duankoi888/adjustable-buck-converter/images/photo-1.jpg

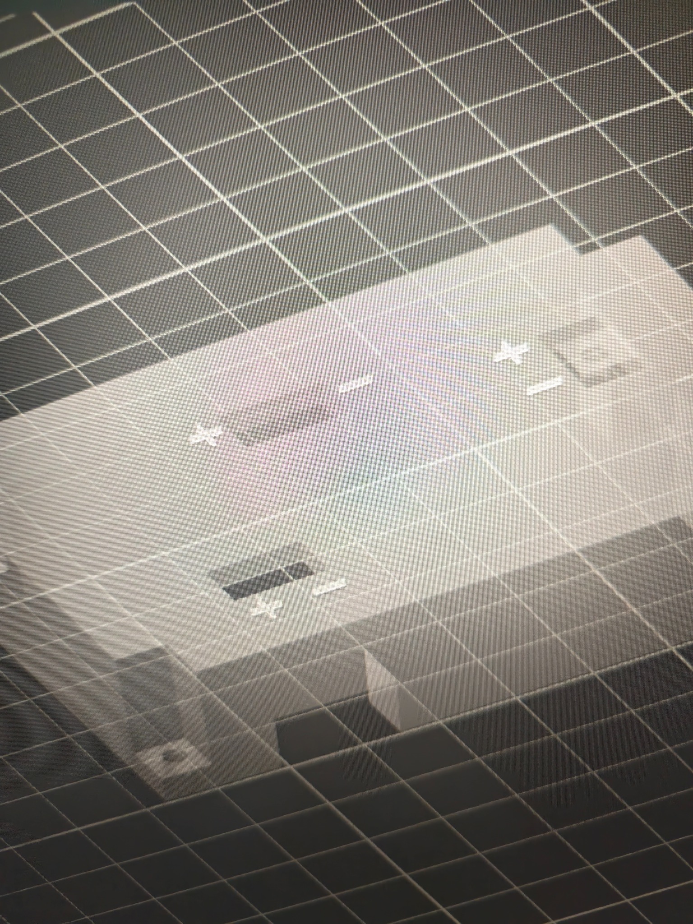
images/photo-1.jpg
