duankoi888/adjustable-buck-converter/images/photo-3.jpg

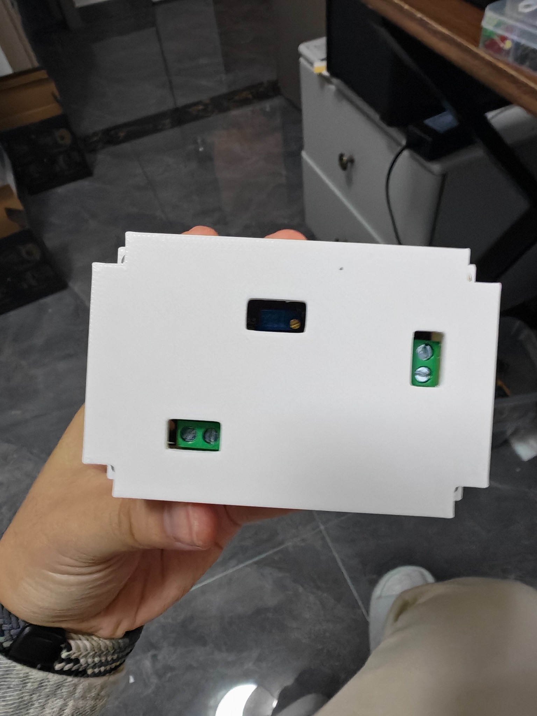
images/photo-3.jpg
