duankoi888/adjustable-buck-converter/docs/bom.xlsx

No. | Quantity | Comment | Designator | Footprint | Value | Manufacturer Part | Manufacturer | Supplier Part | Supplier
1 | 1 | 220uF | C1 | CAP-SMD_BD6.3-L6.6-W6.6-FD-A | 220uF | EFVM035ADA221M0677 | FOLLON(富隆电子) | C22388078 | LCSC
2 | 1 | 470uF | C2 | CAP-SMD_BD10.0-L10.4-W10.4-LS11.2-FD_H12.5 | 470uF | EFVM050ADA471M10C0 | FOLLON(富隆电子) | C22469994 | LCSC
3 | 1 | SS54 | D1 | SMA_L4.4-W2.8-LS5.4-R-RD |  | SS54 | MDD(辰达半导体) | C22452 | LCSC
4 | 1 | SS34 | D2 | SMA_L4.3-W2.6-LS5.2-RD |  | SS34 | MDD(辰达半导体) | C8678 | LCSC
5 | 1 | 68uH | L1 | IND-SMD_L12.5-W12.5 | 68uH | CYH125-68UH | SHOU HAN(首韩) | C7431083 | LCSC
6 | 2 | WJ500V-5.08-2P | P1,P2 | CONN-TH_2P-P5.00_WJ500V-5.08-2P |  | WJ500V-5.08-2P | KANGNEX(康奈克斯电气) | C8465 | LCSC
7 | 2 | 1kΩ | R1,R3 | R0603 | 1kΩ | FRC0603F1001TS | FOJAN(富捷) | C2907002 | LCSC
8 | 1 | 5kΩ | R2 | RES-ADJ-TH_3296W | 5kΩ | 3296W-1-502LF | BOURNS | C60620 | LCSC
9 | 1 | LM2596HVS-ADJ(UMW) | U1 | TO-263-5_L10.0-W8.4-P1.70-LS15.3-BR |  | LM2596HVS-ADJ(UMW) | UMW(友台半导体) | C347447 | LCSC
