duankoi888/adjustable-buck-converter/hardware/enclosure/source/上下盖装配.SLDASM

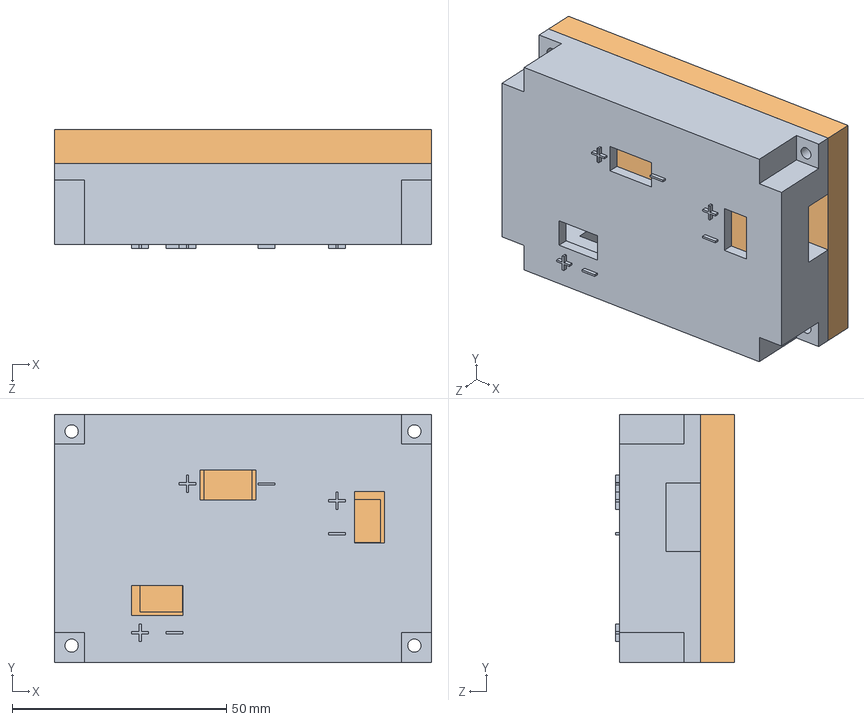
[picture p4: CAD file, 2026-10-30]
hardware/enclosure/source/上下盖装配.SLDASM
88.0 x 58.0 x 27.8 mm
底座_固定
上盖
