duankoi888/adjustable-buck-converter/hardware/enclosure/source/上盖.SLDPRT

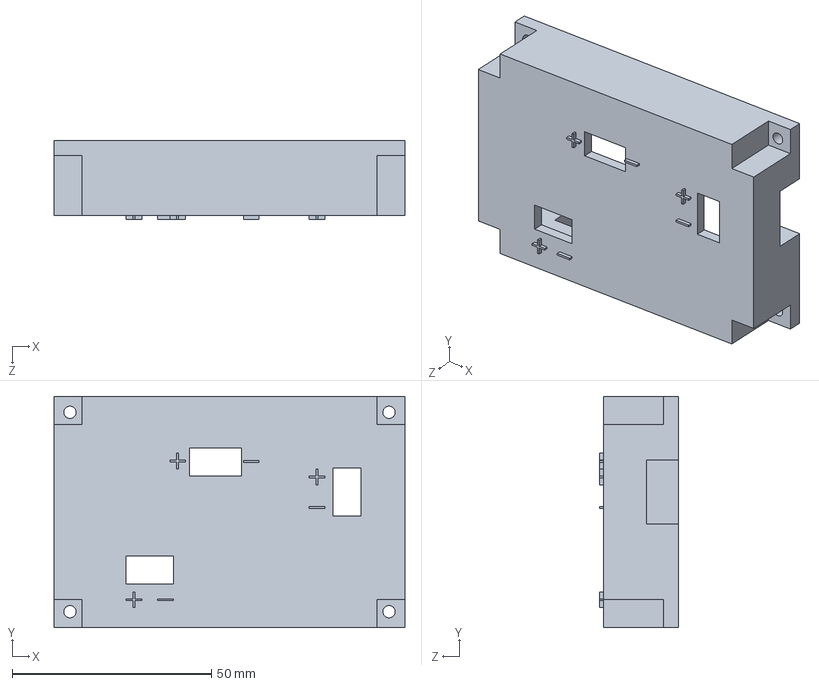
[picture p5: CAD file, 2026-10-30]
hardware/enclosure/source/上盖.SLDPRT
88.0 x 58.0 x 19.8 mm
