duankoi888/adjustable-buck-converter/hardware/enclosure/source/底座.SLDPRT

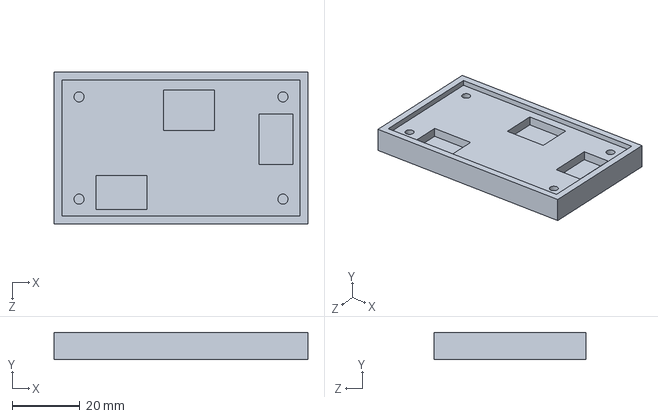
[picture p6: CAD file, 2026-10-30]
hardware/enclosure/source/底座.SLDPRT
75.0 x 8.00 x 45.0 mm
