duankoi888/adjustable-buck-converter/hardware/enclosure/source/底座_等距2.4mm_上槽左移5mm.SLDPRT

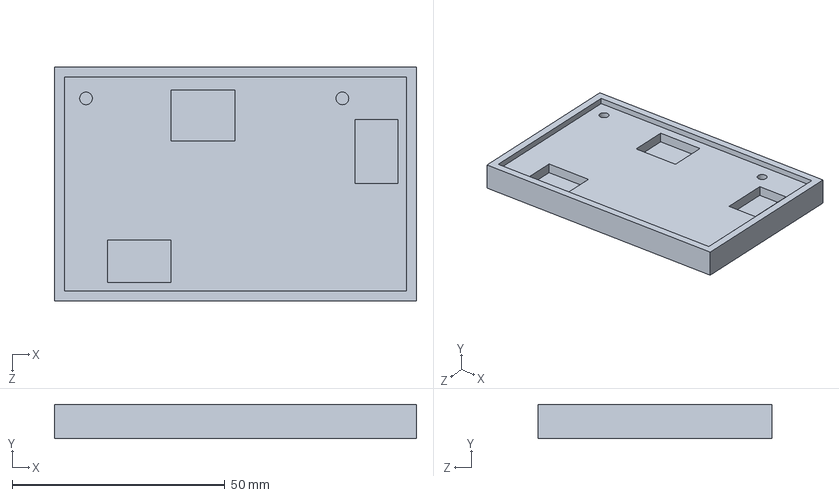
[picture p7: CAD file, 2026-10-30]
hardware/enclosure/source/底座_等距2.4mm_上槽左移5mm.SLDPRT
85.0 x 8.00 x 55.0 mm
