duankoi888/adjustable-buck-converter/hardware/enclosure/source/底座_固定.SLDPRT

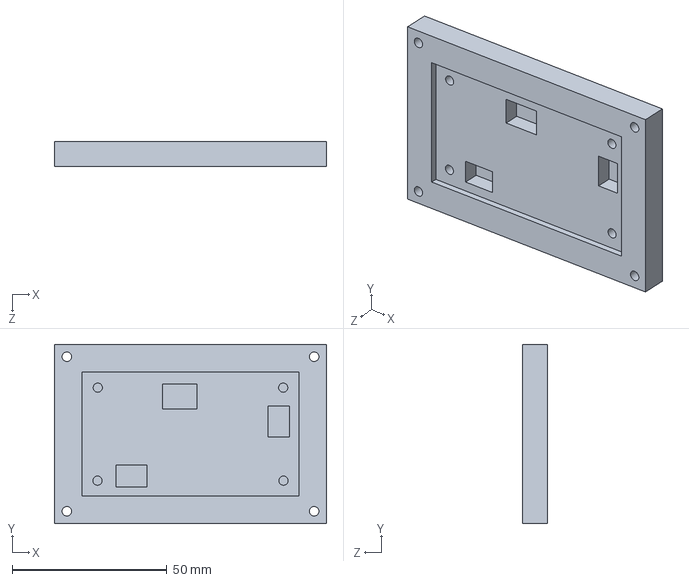
[picture p8: CAD file, 2026-10-30]
hardware/enclosure/source/底座_固定.SLDPRT
88.0 x 58.0 x 8.00 mm
