duankoi888/adjustable-buck-converter/(list of files, cad)

Other CAD files:
hardware/enclosure/source/底座_等距2.4mm.SLDPRT
hardware/enclosure/print/上盖.3MF
hardware/enclosure/print/底座.3mf
hardware/enclosure/print/底座_固定.3MF
hardware/enclosure/print/底座_等距2.4mm.3MF
hardware/enclosure/print/底座_等距2.4mm_上槽左移5mm.3MF
