duankoi888/adjustable-buck-converter/docs/schematic.pdf

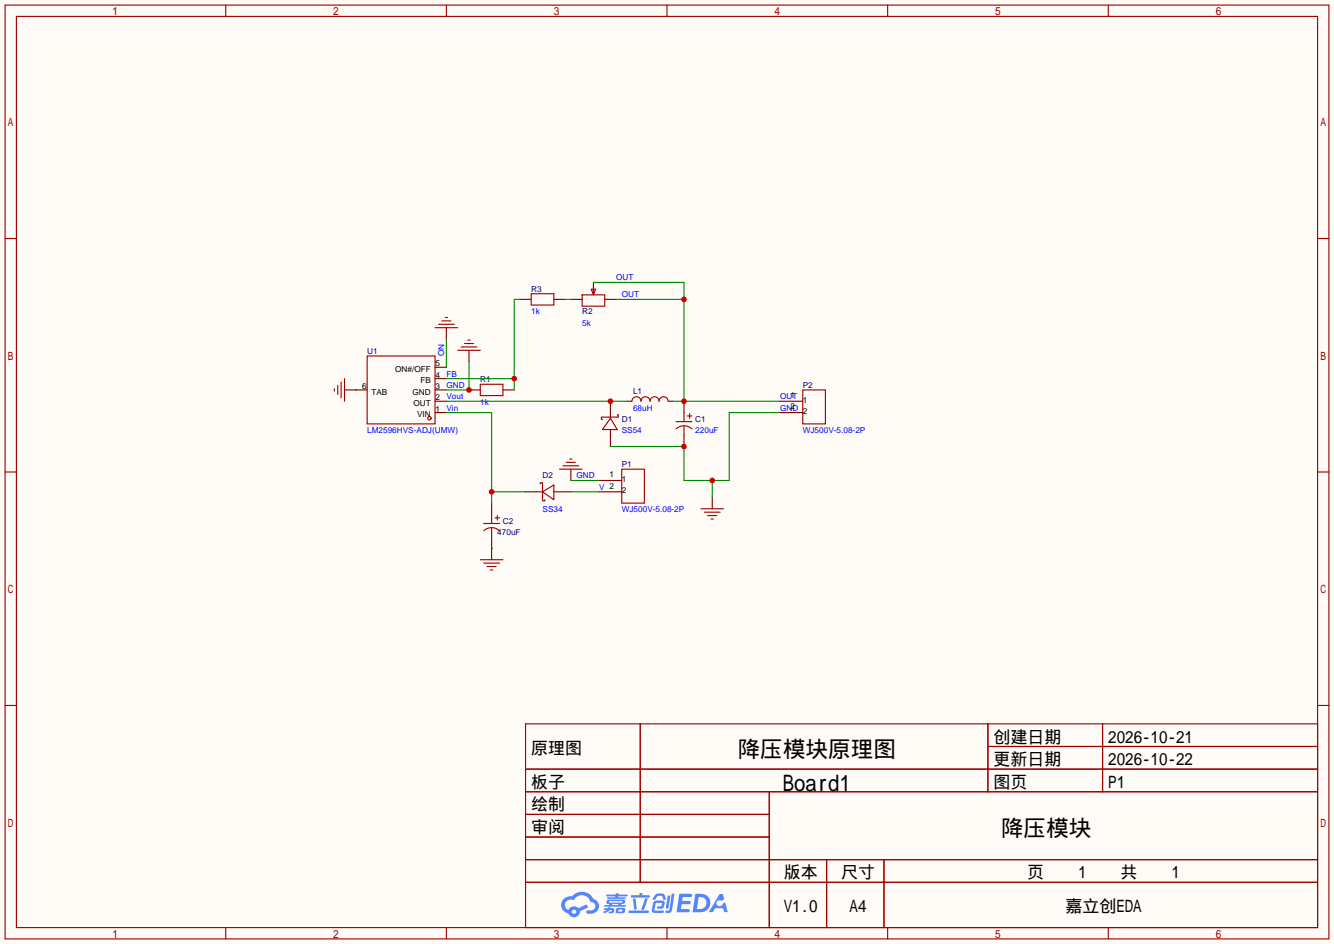
[picture p9: page 1]

原理图 | 降压模块原理图 | 创建日期 | 2026-10-21

更新日期 | 2026-10-22

板子 | Board1 | 图页 | P1
绘制 | | 降压模块
审阅

V1.0 | A4 | 嘉立创EDA
