duankoi888/adjustable-buck-converter/docs/revision-history.md

# 版本与验证记录

| 对象 | 已知状态 | 说明 |
| --- | --- | --- |
| 原布局 PCB | 已装配、已完成基础功能测试 | 可通过滑动变阻器调节输出；尚缺系统化测试数据。 |
| 修改布线后的 PCB | 已设计，实物验证未完成 | 不能标记为已测试。 |
| 2026-10-30 Gerber | 已归档，待核对与验证 | 提交生产前应在嘉立创EDA中核对工程与导出文件。 |
| 外壳 | 按原布局设计 | 包含多个 SolidWorks 和 3MF 迭代，尚未验证与新 PCB 的兼容性。 |

现有两个 EDA 工程文件未附明确的版本映射，故仓库没有擅自将其中一个标成 Rev A、另一个标成 Rev B。后续确认后可补充工程文件与实物板卡的对应关系。
